Raphael-Boichot/SNES-to-NeoGeo-MVS-controller-adapter/PCB/PCB.pptx

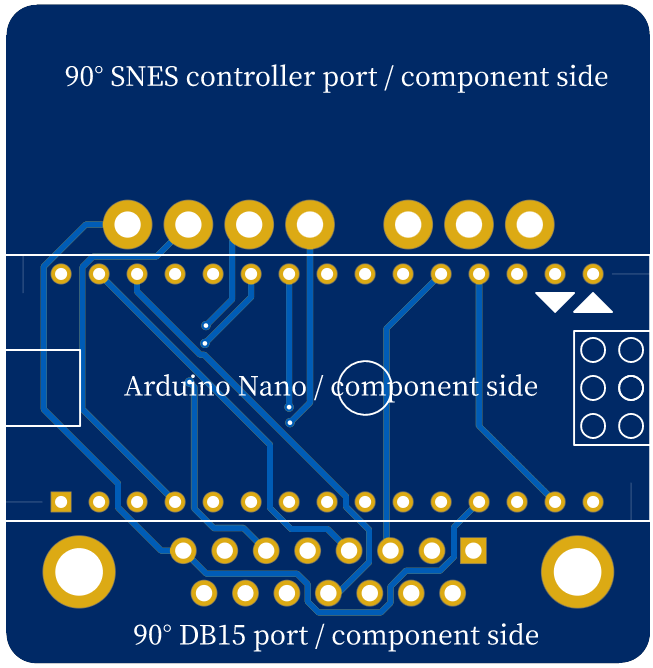
[picture p8: figure]
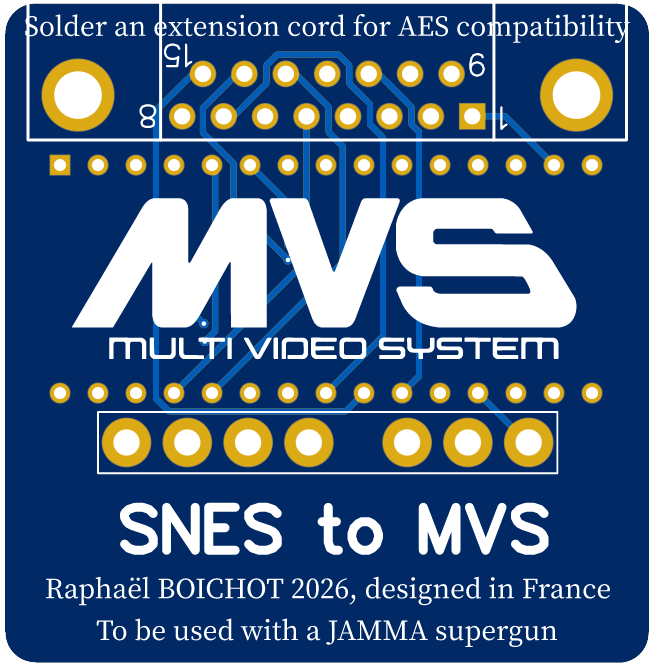
[picture p9: figure]
