Raphael-Boichot/SNES-to-NeoGeo-MVS-controller-adapter/PCB/Schematic_SNES2NEO_2025-12-20.pdf

A | A

1

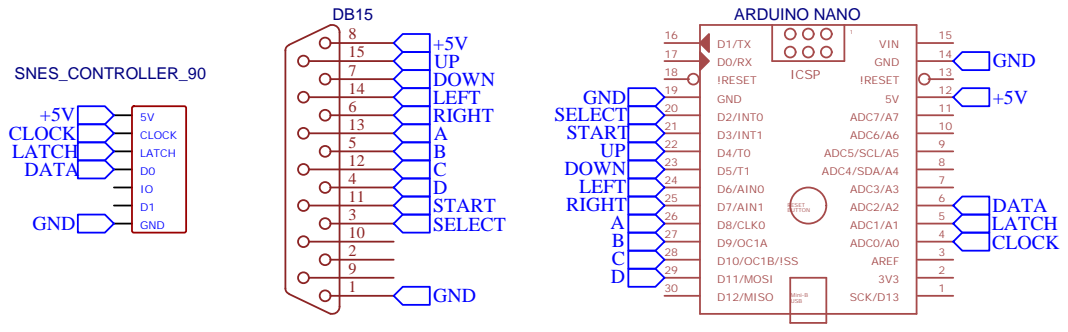
[picture p10: page 1]
