Raphael-Boichot/SNES-to-NeoGeo-MVS-controller-adapter/(list of files, drawings)

Other design files:
PCB/PCB_SNES2NEO_2026-02-28.json
PCB/SCH_SNES2NEO_2025-12-20.json
