Raphael-Boichot/SNES-to-NeoGeo-MVS-controller-adapter/(commit log)

2025-12-20 Untested PCB
    [PCB_SNES2NEO_2025-12-20.json, SCH_SNES2NEO_2025-12-20.json]
2025-12-20 Correct schematic image path in README
    Fixed image path for schematic in README.
2025-12-21 Fix formatting in README.md for Arduino connection
2025-12-21 Correct README formatting for Arduino connections
    Fix formatting issues in Arduino to DB15 connection diagram.
2025-12-21 Correct README formatting for Arduino DB15 diagram
    Fix formatting in the Arduino to DB15 connection diagram.
2026-02-13 Update README with button layout details
    Added button layout information and removed untested note.
2026-02-15 Update README with personal PCB comment
    Added a personal note about the PCB design.
2026-02-15 Add link to SmallCab deluxe supergun schematic
    Updated the description of the supergun schematic to include a link to SmallCab deluxe.
2026-02-28 Update README with assembly warnings and clarifications
    Added warnings about testing the Arduino before assembly and clarified component placement.
2026-02-28 Update warning about Arduino testing before assembly
    Clarified warning about testing Arduino before soldering, emphasizing the importance of checking for defects.
2026-02-28 Update README with Arduino LED blinking details
    Clarified Arduino LED behavior and added testing advice before assembly.
